ElectronicSpaceCat/plink-device-pcb-bt/README.md

# plink-device-pcb-bt

The primary pcb has the bluetooth module (where the firmware resides).
