ElectronicSpaceCat/plink-device-pcb-bt/KiCad/BT/BT.pdf

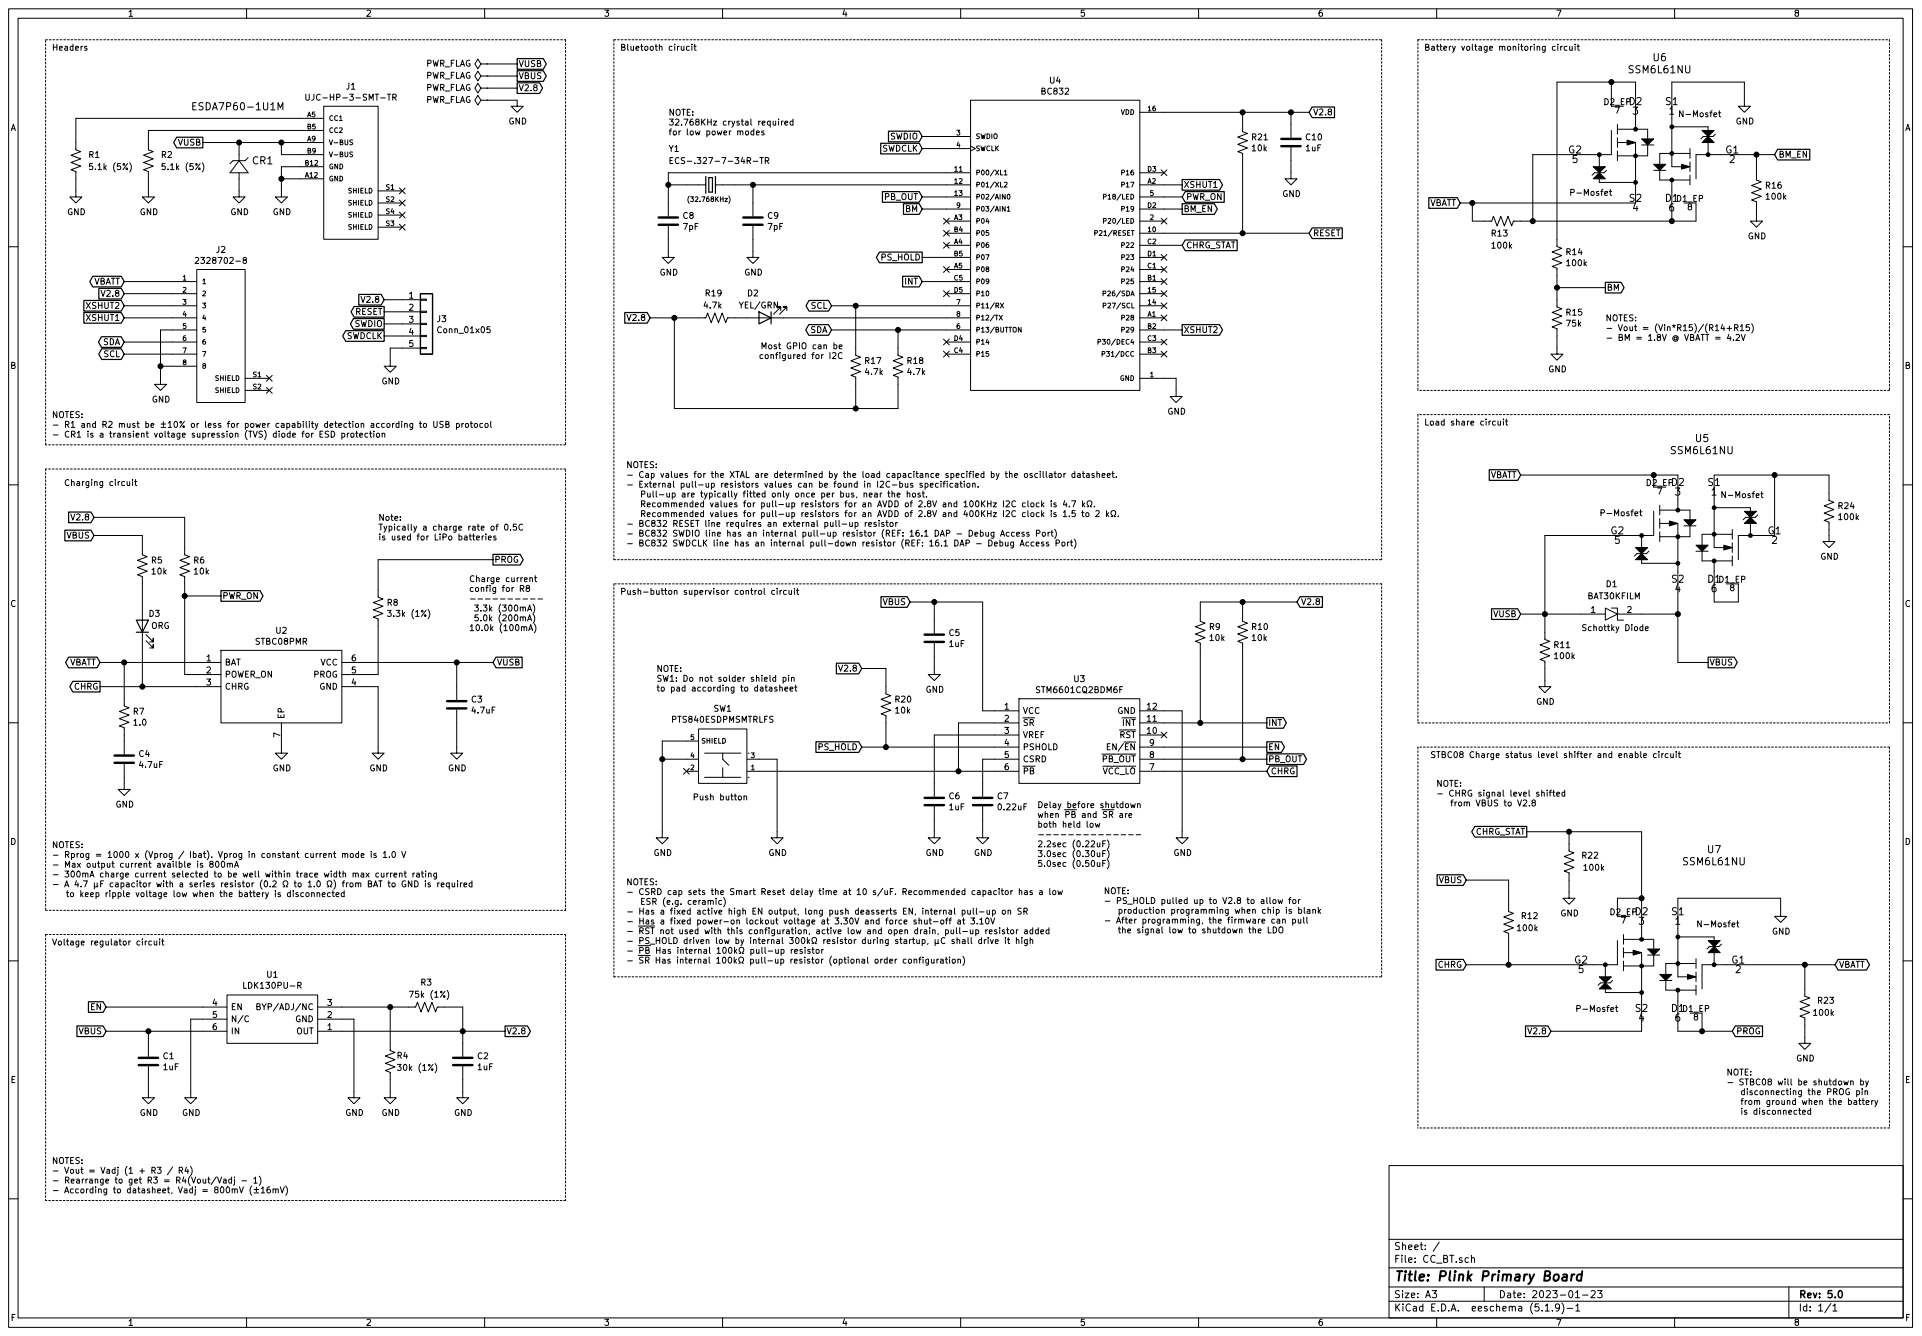
[picture p1: page 1]

Bluetooth cirucit Note: Typically a charge rate of 0.5C

for low power modes
Y1 ECS-.327-7-34R-TR

(32.768KHz) NOTES: - R1 and R2 must be ±10% or less for power capability detection according to USB protocol
GND

Most GPIO can be
configured for I2C

Load share circuit NOTES: - Cap values for the XTAL are determined by the load capacitance specified by the oscillator datasheet.

- External pull-up resistors values can be found in I2C-bus specification.
Pull-up are typically fitted only once per bus, near the host.
Recommended values for pull-up resistors for an AVDD of 2.8V and 100KHz I2C clock is 4.7 k.
Recommended values for pull-up resistors for an AVDD of 2.8V and 400KHz I2C clock is 1.5 to 2 k.
- BC832 RESET line requires an external pull-up resistor
- BC832 SWDIO line has an internal pull-up resistor (REF: 16.1 DAP - Debug Access Port)
- BC832 SWDCLK line has an internal pull-down resistor (REF: 16.1 DAP - Debug Access Port)

is used for LiPo batteries

Schottky Diode NOTE: SW1: Do not solder shield pin

to pad according to datasheet

is disconnected STBC08 Charge status level shifter and enable circuit

NOTE: - CHRG signal level shifted

V2.8 NOTES: - Rprog = 1000 x (Vprog / Ibat). Vprog in constant current mode is 1.0 V

- Max output current availble is 800mA
- 300mA charge current selected to be well within trace width max current rating
- A 4.7 µF capacitor with a series resistor (0.2 to 1.0 ) from BAT to GND is required

ESR (e.g. ceramic)
- Has a fixed active high EN output, long push deasserts EN, internal pull-up on SR
- Has a fixed power-on lockout voltage at 3.30V and force shut-off at 3.10V
- RST not used with this configuration, active low and open drain, pull-up resistor added
- PS_HOLD driven low by internal 300k resistor during startup, C shall drive it high
- PB Has internal 100k pull-up resistor
- SR Has internal 100k pull-up resistor (optional order configuration)

production programming when chip is blank
- After programming, the firmware can pull
the signal low to shutdown the LDO

disconnecting the PROG pin
from ground when the battery

- Rearrange to get R3 = R4(Vout/Vadj - 1)

Id: 1/1 Title: Plink Primary Board
