ElectronicSpaceCat/plink-device-pcb-bt/KiCad/BT/BT.kicad_pcb

## KiCad design KiCad/BT/BT.kicad_pcb (2023-02-25)

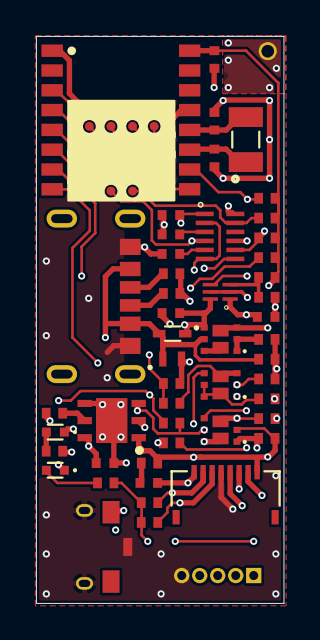
[picture p2: board BT.kicad_pcb from above]

Board: 4 copper layers, 13.8 x 31.5 mm, 50 parts (0 on the bottom side), 39 nets.

Parts:
C1, C2, C5, C6, C10: 1uF; Capacitor_Taiyo_Yuden_0402
C3, C4: 4.7uF; Capacitor_Taiyo_Yuden_0402
C7: 0.22uF; Capacitor_Taiyo_Yuden_0402
C8, C9: 7pF; Capacitor_Taiyo_Yuden_0402
CR1: ESDA7P60-1U1M; ESDA7P601U1M
D1: BAT30KFILM
D2: YEL/GRN; led_QBLP595
D3: ORG; led_QBLP595
J1: UJC-HP-3-SMT-TR; CUI_UJC-HP-3-SMT-TR
J2: 2328702-8; TE_2328702-8
J3: Conn_01x05; PinHeader_1x05_P1.00mm_Vertical
R1, R2: 5.1k (5%); Stackpole_Res_0402
R3: 75k (1%); Stackpole_Res_0402
R4: 30k (1%); Stackpole_Res_0402
R5: 12.5k; Stackpole_Res_0402
R6, R9, R10, R20, R21: 10k; Stackpole_Res_0402
R7: 1.0; Stackpole_Res_0402
R8: 10k (1%); Stackpole_Res_0402
R11, R12, R13, R14, R16, R22, R23, R24: 100k; Stackpole_Res_0402
R15: 75k; Stackpole_Res_0402
R17, R18, R19: 4.7k; Stackpole_Res_0402
SW1: PTS840ESDPMSMTRLFS
U1: LDK130PU-R
U2: STBC08PMR; SON95P300X300X100-7N-D
U3: STM6601CQ2BDM6F; STM6601AQ2BDM6F
U4: BC832; XCVR_BC832
U5, U6, U7: SSM6L61NU
Y1: ECS-.327-7-34R-TR; XTAL_ECS-.327-7-34R-TR

Connections:
BM: R14.2, R15.1, U4.9
BM_EN: R16.1, U4.D2, U6.2
CHRG: D3.1, R12.2, U2.3, U3.7, U7.5
CHRG_STAT: R22.2, U4.C2, U7.3, U7.7
EN: U1.4, U3.9
GND: C1.2, C2.2, C3.2, C4.2, C5.2, C6.2, C7.2, C8.2, C9.2, C10.2, CR1.2, J1.A12, J1.B12, J2.5, J2.8, J3.5, R1.2, R2.2, R4.2, R11.2, R15.2, R16.2, R22.1, R23.1, R24.2, SW1.3, SW1.4, SW1.5, U1.2, U1.5, U2.4, U2.7, U3.12, U4.1, U6.1, U7.1
INT: R9.2, U3.11, U4.C5
unnamed: C4.1, R7.2
unnamed: C6.1, U3.3
unnamed: C7.1, U3.5
unnamed: C8.1, U4.11, Y1.1
unnamed: C9.1, U4.12, Y1.2
unnamed: D2.1, U4.8
unnamed: D2.2, R19.2
unnamed: D3.2, R5.2
unnamed: J1.A5, R1.1
unnamed: J1.B5, R2.1
unnamed: R3.1, R4.1, U1.3
unnamed: R8.2, U2.5
unnamed: R13.1, U6.5, U6.6, U6.8
unnamed: R14.1, U6.3, U6.7
unnamed: R24.1, U5.1, U5.2
unnamed: SW1.1, U3.2, U3.6
unnamed: U5.6, U5.8
PB_OUT: R10.2, U3.8, U4.13
PROG: R8.1, U7.6, U7.8
PS_HOLD: R20.2, U3.4, U4.B5
PWR_ON: R6.2, U2.2, U4.5
RESET: J3.2, R21.2, U4.10
SCL: J2.7, R17.1, U4.7
SDA: J2.6, R18.1, U4.6
SWDCLK: J3.4, U4.4
SWDIO: J3.3, U4.3
V2.8: C2.1, C10.1, J2.2, J3.1, R3.2, R6.1, R9.1, R10.1, R17.2, R18.2, R19.1, R20.1, R21.1, U1.1, U4.16, U7.4
VBATT: J2.1, R7.1, R13.2, R23.2, U2.1, U5.3, U5.7, U6.4, U7.2
VBUS: C1.1, C5.1, D1.2, R5.1, R12.1, U1.6, U3.1, U5.4
VUSB: C3.1, CR1.1, D1.1, J1.A9, J1.B9, R11.1, U2.6, U5.5
XSHUT1: J2.4, U4.A2
XSHUT2: J2.3, U4.B2
